KungfuPancake/lan-2026-trophy/cad/glass.step

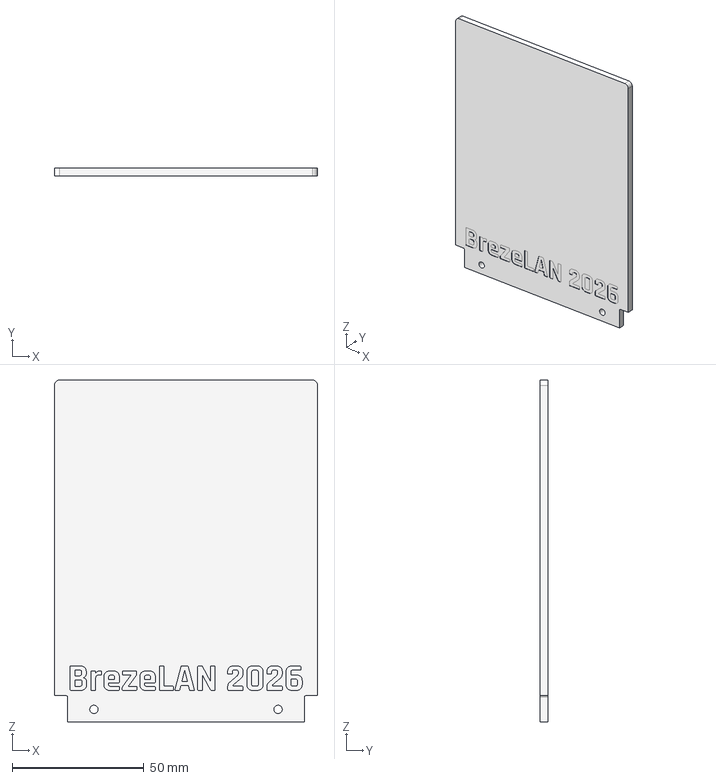
[picture p2: CAD file, 2026-11-09]
cad/glass.step
100.0 x 3.00 x 130.0 mm
