KungfuPancake/lan-2026-trophy/cad/case_back.step

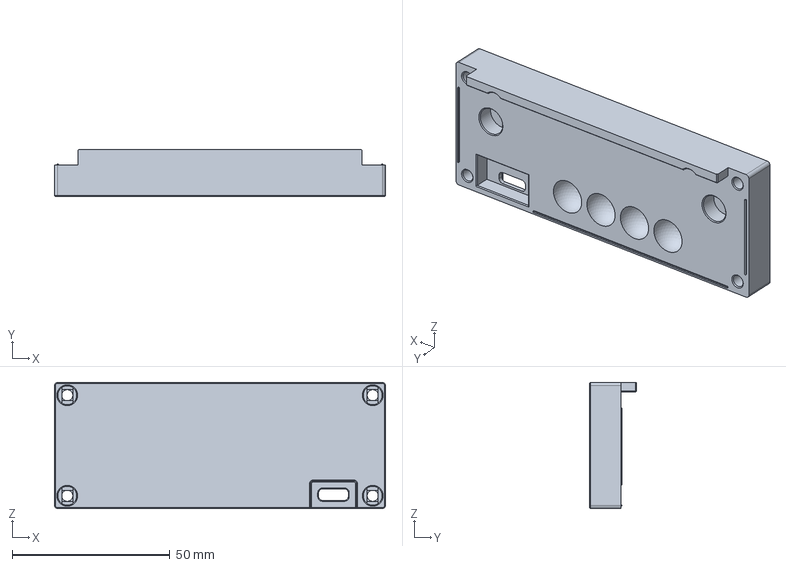
[picture p3: CAD file, 2026-11-09]
cad/case_back.step
105.0 x 15.0 x 40.0 mm
