KungfuPancake/lan-2026-trophy/cad/case_front.step

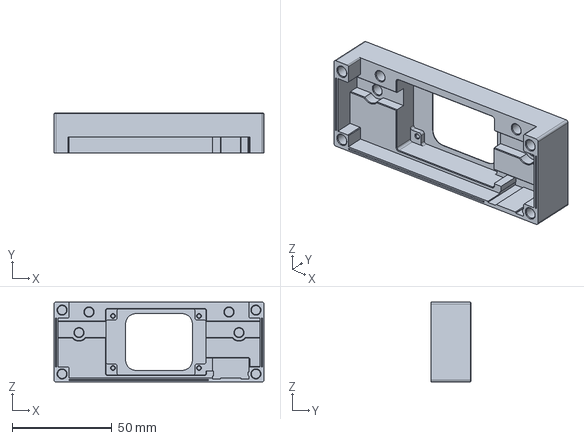
[picture p4: CAD file, 2026-11-09]
cad/case_front.step
105.0 x 20.0 x 40.0 mm
