KungfuPancake/lan-2026-trophy/cad/led_strip_carrier.step

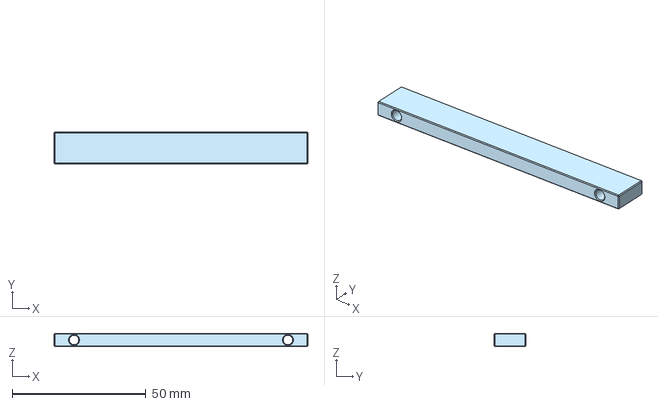
[picture p5: CAD file, 2026-11-09]
cad/led_strip_carrier.step
95.0 x 12.0 x 5.00 mm
