KungfuPancake/lan-2026-trophy/(list of files, cad)

Other CAD files:
stl/case_back.stl
stl/case_front.stl
stl/led_strip_carrier.stl
